Anitei2602/Senzor-de-gaz/Documentatie senzor de gaz.pdf

Universitatea Tehnică din Cluj-Napoca

### Facultatea de Electronică, Telecomunicații și Tehnologia Informației

## Proiect la disciplina „Tehnici CAD”

Student:Aniței Gabriela

2023-2024

Universitatea Tehnică din Cluj-Napoca

### Facultatea de Electronică, Telecomunicații și Tehnologia Informației

## Circuit pentru controlul concentrației de gaz metan într-o incintă

Student:Aniței Gabriela

2023-2024

CURPINS

## 1. Specificații de proiectare 2. Schema bloc 3. Schema electrică

### 3.1. Etaj citire senzor 3.2. Etaj de conversie a domeniului tensiunii de iesire 3.3. Etaj de comparare(praguri) 3.4 Releu/LED

## 4. Simularea finală 5. Referințe

## 1. Specificații de proiectare

Să se proiecteze un sistem care utilizează senzori rezistivi de gaz pentru a menține într-o incintă concentrația de metan între limitele specificate în coloana E. În incintă există o sursă care generează în continuu gaz metan. În momentul în care concentrația a ajuns la limita superioară (coloana E) sistemul va porni ventilatorul care va introduce aer curat. Când concentrația de metan ajunge la limita inferioară (coloana E) sistemul va da comanda de oprire a ventilatorului.

Din foaia de catalog a senzorului se știe că la o variație a concentrației de gaz specificată în coloana F rezistența electrică a senzorului variază liniar în domeniul specificat în coloana G. Variația rezistenței electrice a senzorului trebuie convertită într-o variație de tensiune în domeniul [2÷(Vcc-2V)]. Vcc este specificat în coloana H.

Ventilatorul este comandat de un comparator cu histereză prin intermediul unui releu care este modelat cu un rezistor. Starea ventilatorului (pornit/oprit) este semnalizată de un LED de culoare specificată în coloana I a tabelului 1.

Tabel 1. Speficații de proiectare

E | F | G | H | I
Concentrația de metan in incintă[ppm] | Domeniul de măsură a senzorului[ppm] | Rezistența senzorului[Ω] | Vcc[V] | Culoare LED
500 … 4.000 | 200 … 5.000 | 50k – 25k | 10 | Portocaliu

## 2. Schema bloc

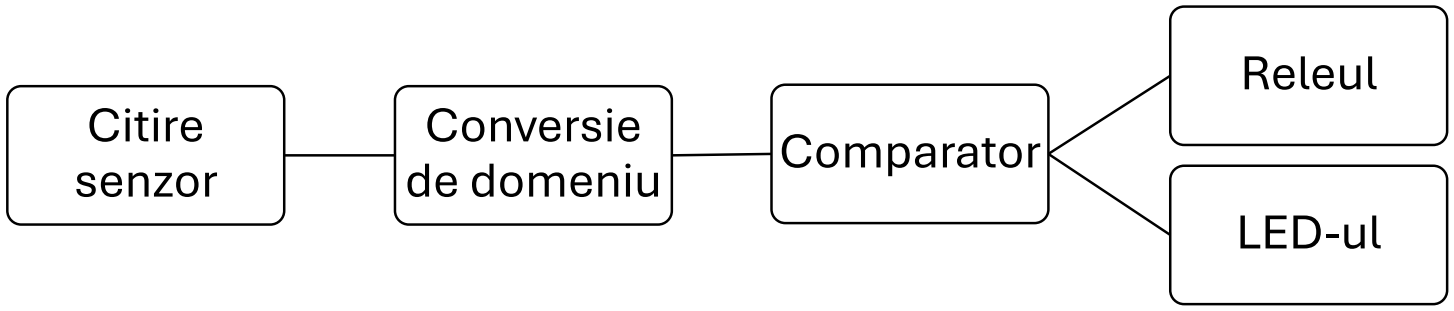
[picture p1: figure]
Citire senzor; Conversie; de domeniu; Comparator; Releul; LED-ul

Figura 1. Schema bloc a circuitului

## 3. Schema electrică

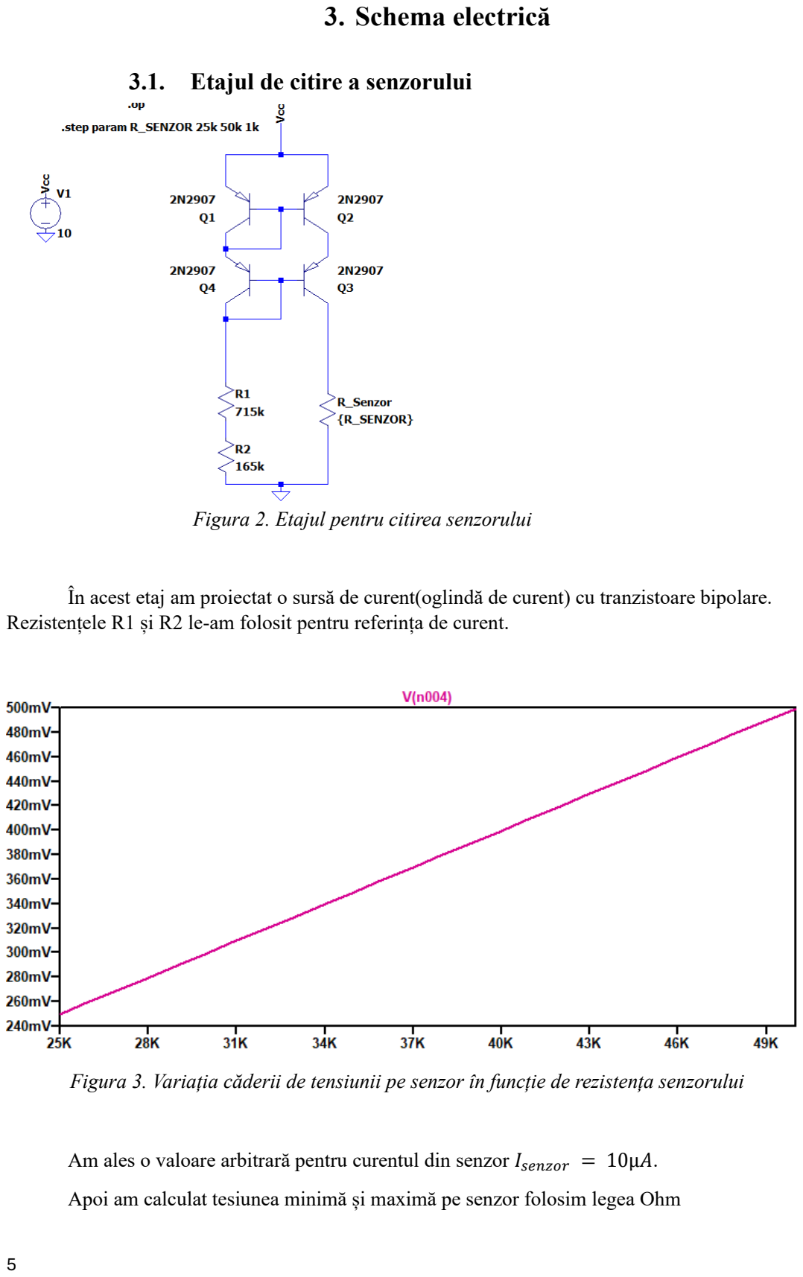
[picture p2: page 6]

### 3.1. Etajul de citire a senzorului

Figura 2. Etajul pentru citirea senzorului

În acest etaj am proiectat o sursă de curent(oglindă de curent) cu tranzistoare bipolare. Rezistențele R1 și R2 le-am folosit pentru referința de curent.

Figura 3. Variația căderii de tensiunii pe senzor în funcție de rezistența senzorului

Am ales o valoare arbitrară pentru curentul din senzor Isenzor = 10µA.

Apoi am calculat tesiunea minimă și maximă pe senzor folosim legea Ohm

V = I × R (1)

Vsenzor_minim = 10µA × 25kΩ = 10 × 10⁻⁶ × 25 × 10³ = 250mV (1.1)

Vsenzor_maxim = 10µA × 50kΩ = 10 × 10⁻⁶ × 50 × 10³ = 500mV (1.2)

Pentru alegerea rezistenței echivalente pentru curent am folosit formula

Isenzor =

Vcc − 2 × VBE
R

(2)

(2) → R =

Vcc − 2 × VBE

Isenzor

=

10V − 2 × 0.6V
10µA

= 880kΩ (2.1)

Din cauza faptului că nu avem rezistență de 880kΩ am ales R1 = 715kΩ și în urma calculelor a rezultat R2 = 165kΩ.

R = R1 + R2 (3)

### 3.2. Etaj de conversie a domeniului tensiunii de iesire

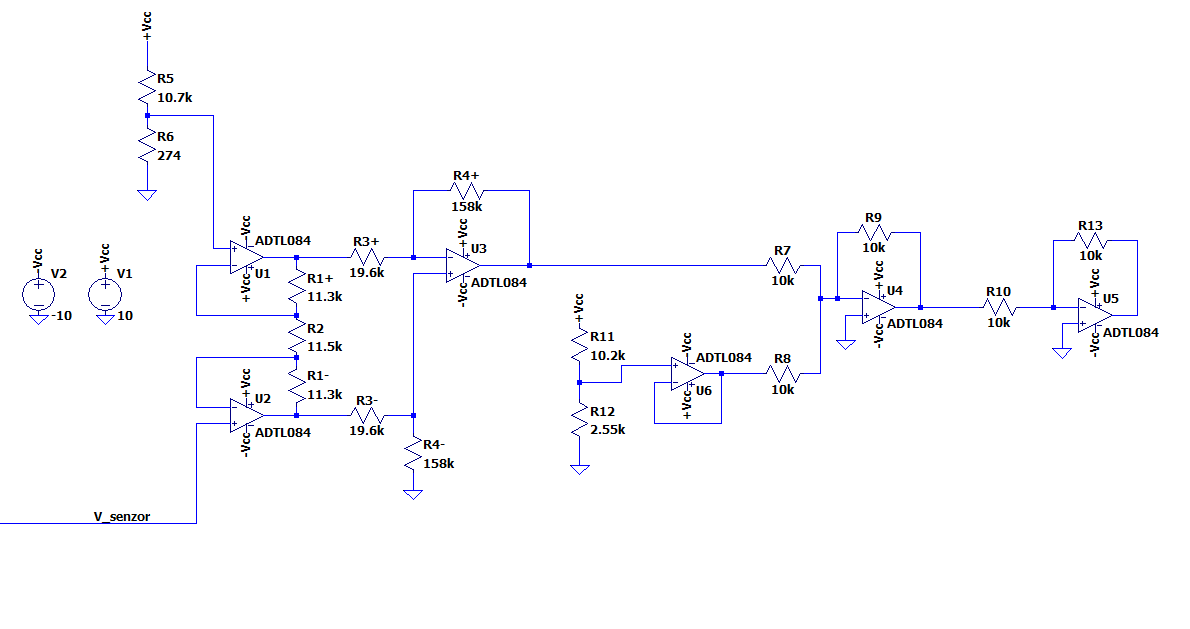
[picture p3: figure]

Figura 4. Etajul pentru conversia de domeniu

Variația tensiunii pe senzor se află în intervalul [250mV – 500mV]. Conform specificațiilor de proiectare aceasta trebuie adusă în intervalul [2V – 8V], iar pentru a realiza asta am folosit un amplificator de intrusmentație și un sumator. Această operație este descrisă mai jos:

Vconversie = (Vsenzor − 250mV) × 24 + 2V (4)

Câștigul amplificatorului de instrumentație este exprimat în relație (5), folosind notațiile: R1+ = R1- = R1, R3+ = R3- = R3, R4+ = R4- = R4.
R4
R3

(1 + 2 ×

R1
R2

) = 24 (5)

Pentru obținerea valorilor rezistențelor, valoarea parantezei din relația (5) a fost aleasă arbitrar ca fiind 3, alegând R1 = 11.3kΩ și R2 = 11.5kΩ. Astfel primul raport al relației ia valoarea
8. R3 a fost ales arbitrar cu valoarea de 19.6kΩ, iar R4 cu valoarea de aproximativ 8 ori mai mare (≈ 158kΩ).

Amplificatorul de instrumentație deplasează și scalează aceasta varianție în intervalul [0V – 6V]. Circuitul de însumare adaugă înca 2V pentru a translata domeniul de varianție între [2V – 8V]. Deoarece ieșirea este inversată am folosit un amplificator inversor cu amplificare -1. Tensiunea de referință de 2V pentru circuitul de însumare este obținută cu un divizor de tensiune. Adaptarea de impedanță între divizorul de tensiune și intrarea circuitului sumator este necesară deoarece curentul absorbit la intrarea AO este comparabil cu curentul care trece prin divizorul de tensiune.

Am folosit ecuația dreptei:

X − Xa
Xb − Xa

=

Y − Ya
Yb − Ya

(6)

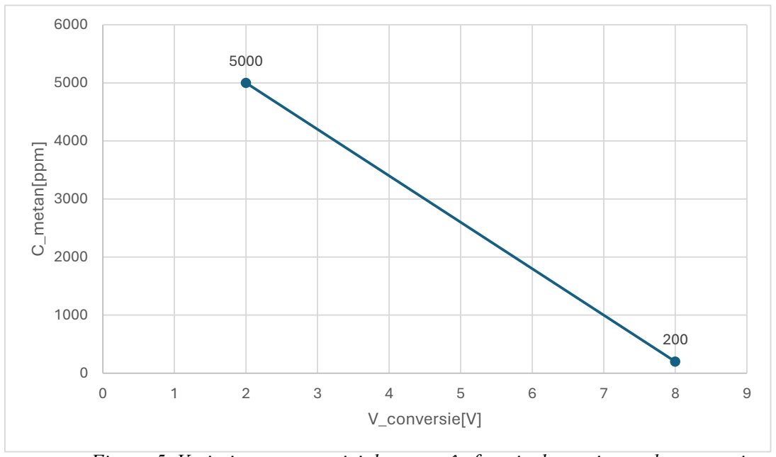
[picture p4: figure]
C_metan[ppm]; V_conversie[V]

Figura 5. Variația concentrației de metan în funcție de tensiunea de conversie

Din ecuația (6): Vconversie − 8V
2V − 8V

=

Cmetan − 200ppm
5000ppm − 200ppm

(7)

Din ecuația (7): Vconversie =

(200ppm − Cmentan)×6V
4800ppm

+ 8V (8)

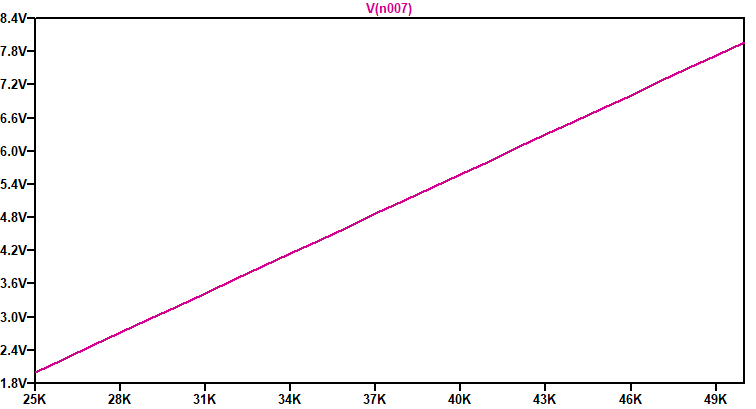
[picture p5: figure]

Figura 6. Conversia de domeniu

### 3.3. Etajul de comparare

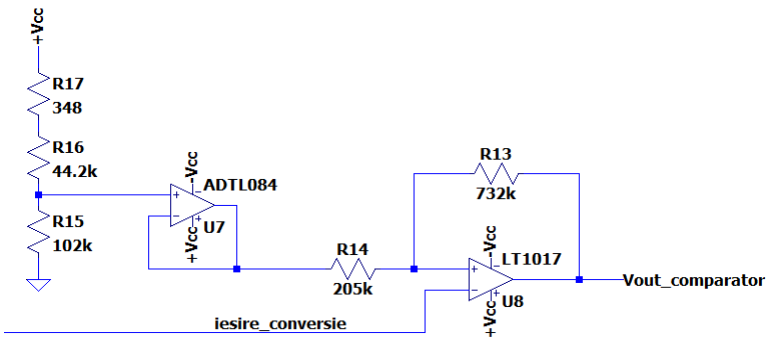
[picture p6: figure]

Figura 7. Comparator

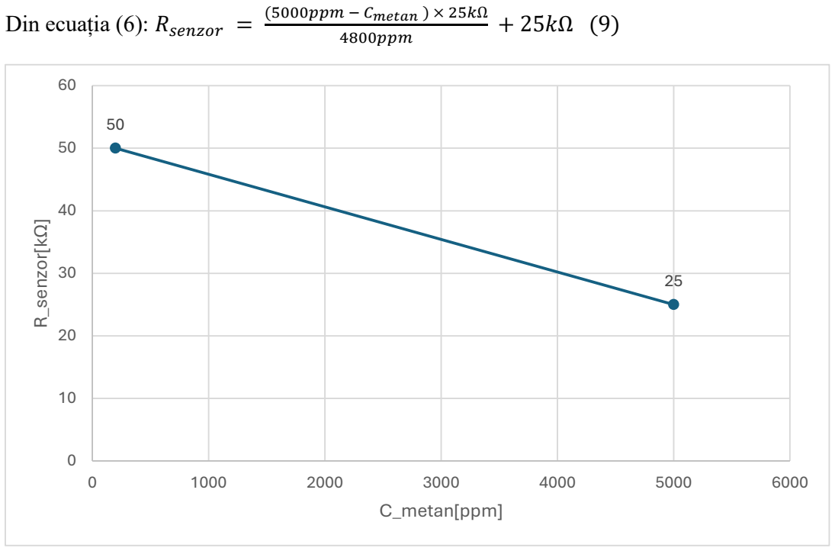
[picture p7: figure]
Din ecuația (6): Rsenzor =; (5000ppm − Cmetan ) × 25kΩ; 4800ppm; R_senzor[k; C_metan[ppm]

Figura 8. Rezisența senzorului în funcție de concentrația de gaz

Înlocuind Cmetan cu 4.000 și apoi cu 500 în ecuația (9) am obținut valorile rezistenței senzorului pentru care ventilatorul pornește sau se oprește:

Rsenzor_on = 30.20833kΩ (9.1)

Rsenzor_off = 48.4375kΩ (9.2)

Înlocuind Cmetan cu 4.000 și apoi cu 500 în ecuația (8) am obținut valorile tensiunilor de prag pentru care ventilatorul pornește sau se oprește:

Vpj = 3.25V (8.1)

Vps = 7.625V (8.2)

Conform teoriei de funcționare a comparatorului inversor cu reacție si tensiune de referință avem următoarele ecuații:

Vpj = Vref ×

R13
R13 + R14

+

R14
R14 + R13

× (−VCC) (10)

Vps = Vref ×

R13
R13 + R14

+

R14
R14 + R13

× VCC (11)

Rezistențele R13 și R14 reies din următoarele relații: R14
R14 + R13

× VCC =

Vps − Vpj
2

(12)

R14
R14 + R13

=

Vps − Vpj

2VCC

→ R13 ≈ 3.57 × R14 (13)

Tensiunea de referință pentru comparator este obținută dintr-un divizor de tensiune și un repetor pentru adaptare de impedanță. Vref ≈ 6.96V

### 3.4. Releul și LED-ul

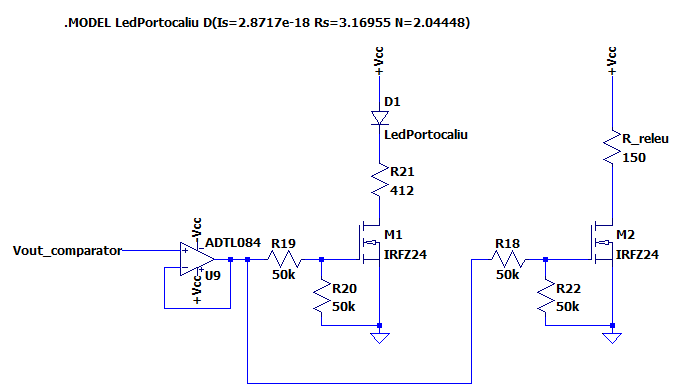
[picture p8: figure]

Figura 9. Schema etajului de comutație pentru releu și LED ( + modelul SPICE pentru LED)

Pentru comandarea activării releului și a LED-ului prin tensiunea de ieșire a comparatorului am utilizat două tranzistoare MOSFET IRFZ24, unul pentru LED, iar celălalt pentru releu.

### 3.4.1. Releul

Releul utilizat este produs de compania TE Connectivity și are codul 6-1393806-4. Conform foii de catalog, bobina are rezistența de 150Ω la tensiunea nominală de 10V.

### 3.4.2. LED-ul

Conform specificațiilor de proiectare, starea ventilatorului este semnalizată de un LED de culoare portocalie. LED-ul utilizat este produs de compania Vishay și are codul TLHF42U1V2-35.

Led-ul funcționează pe baza ecuației lui Shockley:

ID = IS × (e

VD
n × VT − 1) (14)

Pentru a crea modelul SPICE al LED-ului, este necesară cunoașterea curentului de saturație (IS), coeficientului de emisie n și a rezistenței parazite Rs. logaritmând ecuația (14) și înlocuind Rs, se obține ecuația:

VD − RS × ID = n × VT × ln(

ID
IS

− 1) (15)

Digitalizând caracteristica I-V în polarizare directă (din foaia de catalog) utilizând PlotDigitizer, pentru a obține un set de valori pentru ID și VD care pot fi utilizate într-o analiza de registre împreuna cu ecuața (15) pentru a determina parametrii de model ai LED-ului. Pentru această analiză am folosit DESMOS. Parametrii sunt enumerați în tabelul 2.

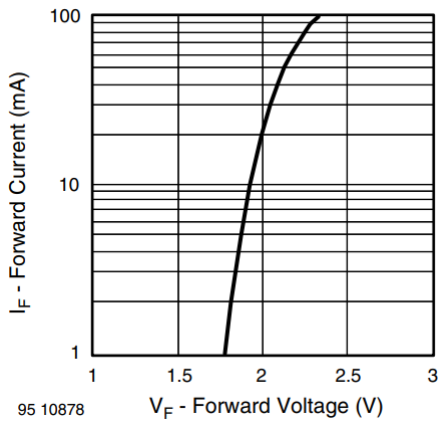
[picture p9: figure]

Figura 10. Caracteristica curent tensiune a LED-ului

Tabelul 2. Parametrii de model SPICE ai LED-ului utilizat

IS[A] | RS[Ω] | n
2.8717 × 10⁻¹⁸ | 3.16955 | 2.04448

Conform foii de catalog, LED-ul luminează optim atunci cand este parcus de un curent de 19.76mA. Acest curent corespunde unei căderi de tensiune 1.98V pe LED. Valoarea rezistenței conectată în serie cu LED-ul este dimensionată astfel(alegând cea mai apropiată valoare din seria E96; am considerat rezistența tranzistorului M1 neglijabilă):

R21 =

VCC − VLED

ILED

=

10V − 1.98V
19.76mA = 405Ω (16)

## 4. Simulări

### 4.1. Simularea senzorului de gaz, a sursei de curent și a convertorului de

domeniu

Pentru simularea sursei de curent, a senzorului de gaz și a convertorului de domeniu am folosit analiza principală a punctului static de funcționare (.op) împreună cu o analiză parametrică pentru variația rezistenței senzorului de gaz în domeniul specificat în cerința de proiectare.

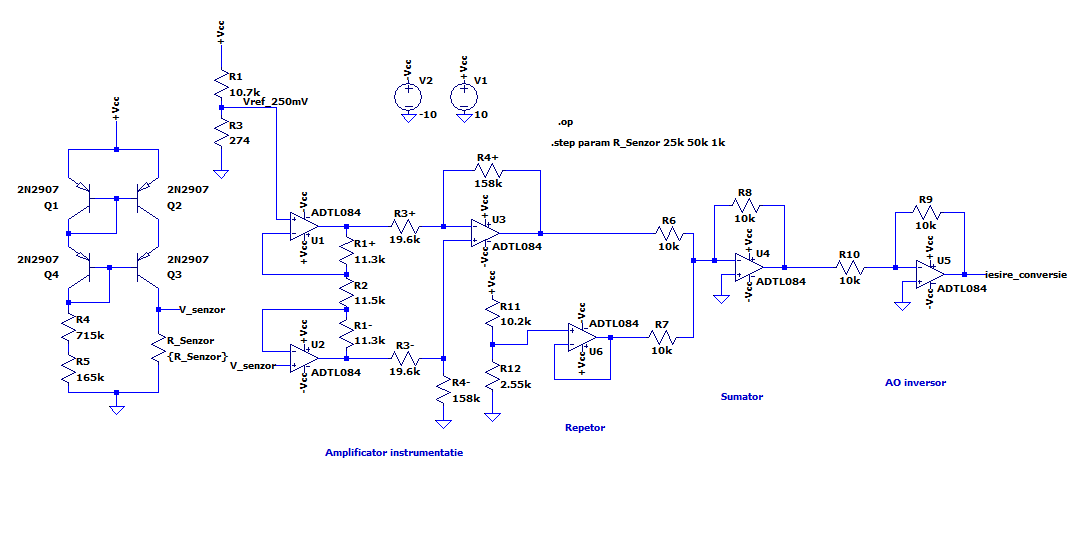
[picture p10: figure]

Figura 11. Schema folosită la simularea senzorului, sursei de curent și a convertorului de domeniu

În figura 12 se poate observa o variație liniară a tensiunii pe senzor, curpinsă intre 250mV și 500mV. Tensiunea la ieșirea convertorului de domeniu variază liniar, între 2V și 8V, conform specificațiilor de proiectare. Curentul injectat în senzor este constant și ales arbitrar, având valoarea de 10µA.

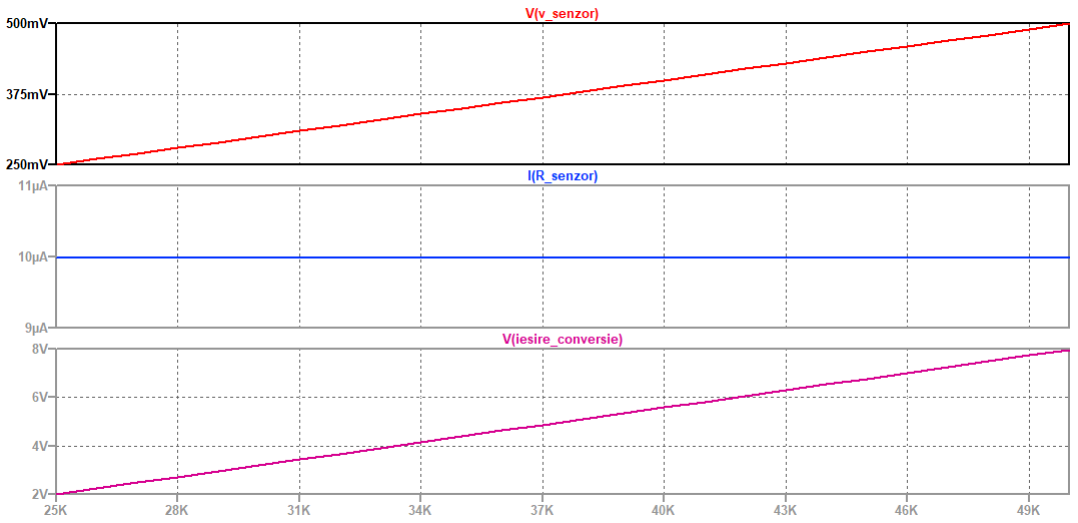
[picture p11: figure]

Figura 12. Rezultatele simulării senzorului, sursei de curent și a convertorului de domeniu

### 4.2. Simularea comparatorului și a etajului de comutație

Pentru simularea comparatorului și a etajului de comutație am folosit o analiza tranztorie, la intrarea comparatorului am folosit ieșirea de la etajul de conversie. În figura 14 poate fi observată activarea ventilatorului atunci când tensiunea de la ieșirea convertorului scade sub pragul de 3.25V și dezactivarea acestuia atunci când ieșirea convertorului crește peste 7.625V(conform tesniunilor obținute în proiectare). Când ventilatorul este activat, LED-ul e aprinde, fiind parcurs de un curent de 19.76mA, iar releul este cuplat, bobina acestuia fiind străbătută de un curent de 66.66mA(conform foii de date a releului, pentru bobina cu tesniunea nominală de 10V).

Sursa de tensiune conc_gaz este un artificiu pe care l-am folosit pentru a simula variația în timp a concentrației de gaz, și am aplicat-o pe senzor folosind formula (17), în care Ltspice consideră doar modulul tesniunii:

Rsenzor = 1000 ×

9800 − V(conc_gaz)
192 | (17)

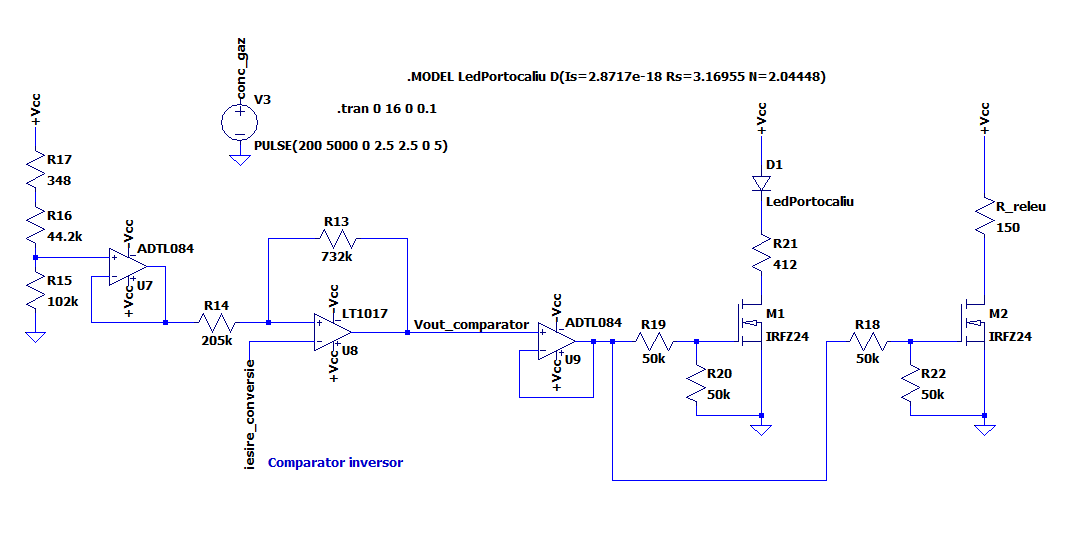
[picture p12: figure]

Figura 13. Schema folosită la simularea comparatorului și a etajului de comutație

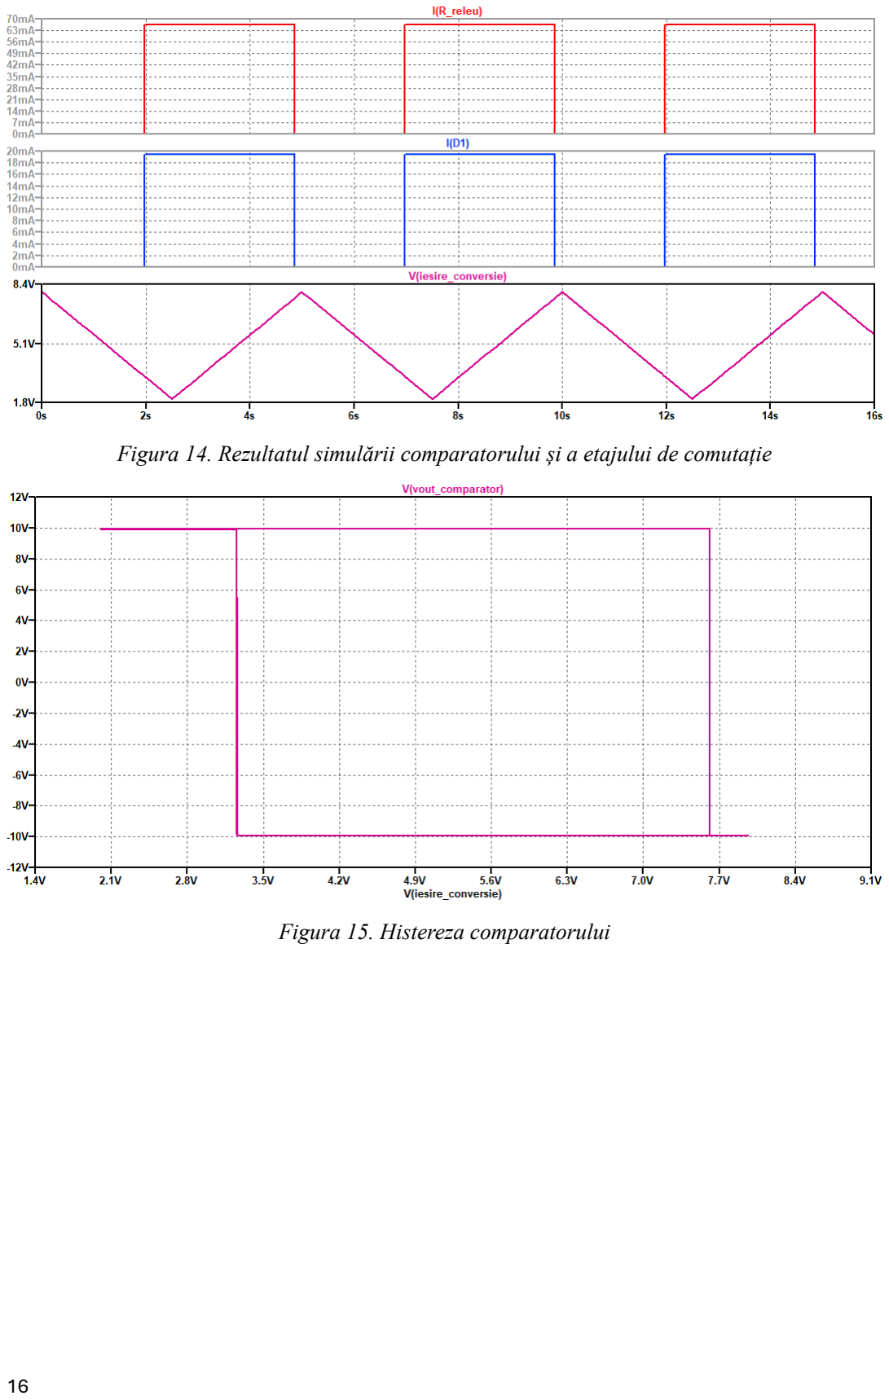
[picture p13: page 17]

Figura 14. Rezultatul simulării comparatorului și a etajului de comutație

Figura 15. Histereza comparatorului

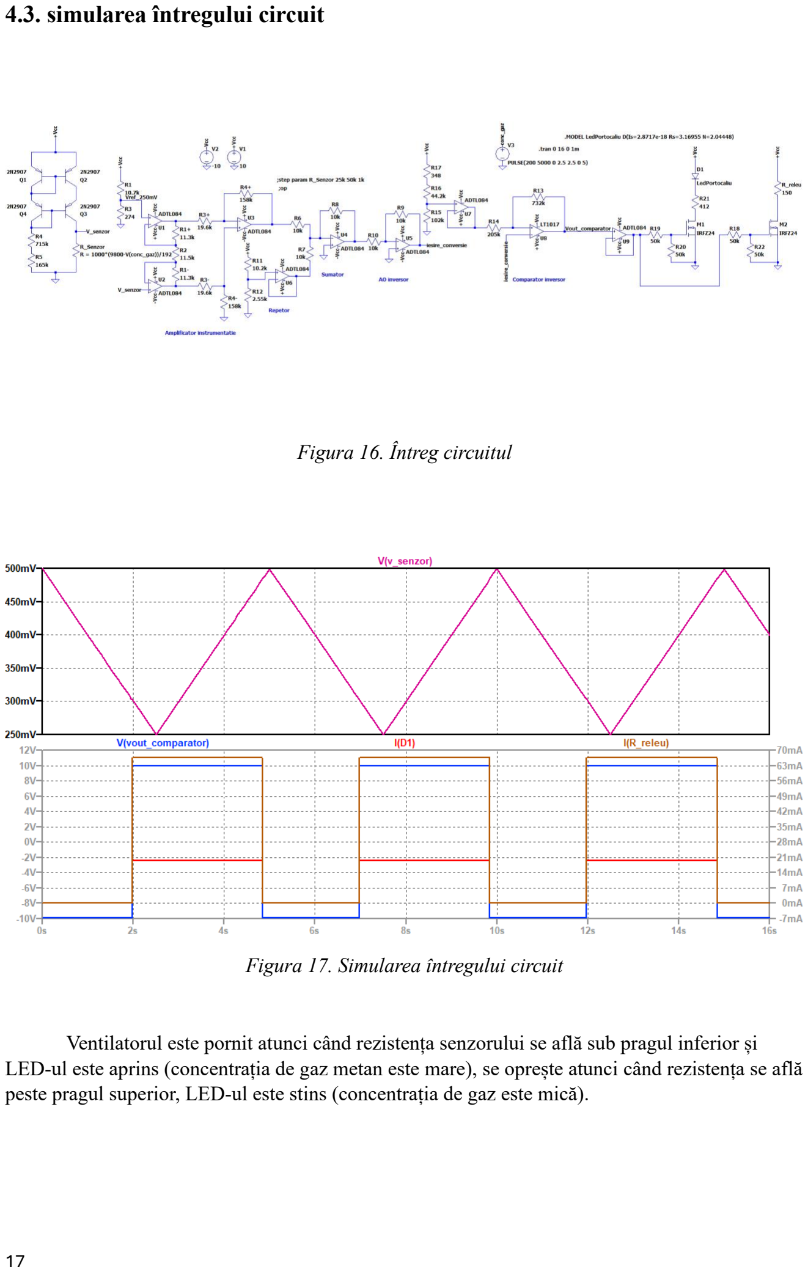
[picture p14: page 18]

### 4.3. simularea întregului circuit

Figura 16. Întreg circuitul

Figura 17. Simularea întregului circuit

Ventilatorul este pornit atunci când rezistența senzorului se află sub pragul inferior și LED-ul este aprins (concentrația de gaz metan este mare), se oprește atunci când rezistența se află peste pragul superior, LED-ul este stins (concentrația de gaz este mică).

## 5. Referințe

1. Notițele proprii de la cursul de CIA
2. Notițele proprii de la cursul de DE
3. Notițele proprii de la cursul de CEF
4. Releul:
https://www.te.com/commerce/DocumentDelivery/DDEController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 (https://www.te.com/commerce/DocumentDelivery/DDEController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)
5. LED-ul: https://ro.mouser.com/ProductDetail/Vishay-Semiconductors/TLHF42U1V2-35?qs=5csRq1wdUj5UIDx1wbQmnw%3D%3D (https://ro.mouser.com/ProductDetail/Vishay-Semiconductors/TLHF42U1V2-35?qs=5csRq1wdUj5UIDx1wbQmnw%3D%3D)
6. Pentru digitalizarea graficului I-V a LED-ului: https://plotdigitizer.com/
7. Pentru aflarea parametrilor pentru model SPICE de la LED: https://www.desmos.com/
8. Pentru modelarea LED-ului: https://codeinsecurity.wordpress.com/2024/01/15/turning-diode-and-led-datasheet-iv-plots-into-spice-models/ (https://codeinsecurity.wordpress.com/2024/01/15/turning-diode-and-led-datasheet-iv-plots-into-spice-models/)
9. Rezistențele sunt din seria standaridizată E96 cu toleranță de 10% https://www.rfcafe.com/references/electrical/resistor-values.htm
10. Altele: https://www.analog.com/en/resources/design-tools-and-calculators.html
