Anitei2602/Senzor-de-gaz/SCHEMA_FINALA.asc

D1: diode; LedPortocaliu
M1: nmos; IRFZ24
M2: nmos; IRFZ24
Q1: pnp; 2N2907
Q2: pnp; 2N2907
Q3: pnp; 2N2907
Q4: pnp; 2N2907
R1+: res; 11.3k
R1-: res; 11.3k
R1: res; 10.7k
R2: res; 11.5k
R3+: res; 19.6k
R3-: res; 19.6k
R3: res; 274
R4+: res; 158k
R4-: res; 158k
R4: res; 715k
R5: res; 165k
R6: res; 10k
R7: res; 10k
R8: res; 10k
R9: res; 10k
R10: res; 10k
R11: res; 10.2k
R12: res; 2.55k
R13: res; 732k
R14: res; 205k
R15: res; 102k
R16: res; 44.2k
R17: res; 348
R18: res; 50k
R19: res; 50k
R20: res; 50k
R21: res; 412
R22: res; 50k
R_releu: res; 150
R_Senzor: res; R = 1000*(9800-V(conc_gaz))/192
U1: ADTL084
U2: ADTL084
U3: ADTL084
U4: ADTL084
U5: ADTL084
U6: ADTL084
U7: ADTL084
U8: LT1017
U9: ADTL084
V1: voltage; 10
V2: voltage; -10
V3: voltage; PULSE(200 5000 0 2.5 2.5 0 5)
Named nets: +Vcc, 0, -Vcc, conc_gaz, Vout_comparator, Vref_250mV, V_senzor, iesire_conversie
;op
;step param R_Senzor 25k 50k 1k
.MODEL LedPortocaliu D(Is=2.8717e-18 Rs=3.16955 N=2.04448)
Amplificator instrumentatie
Repetor
Sumator
AO inversor
Comparator inversor
.tran 0 16 0 1m
